Picatout/PICvision/docs/assy-completed-with-mcu-installed.JPG

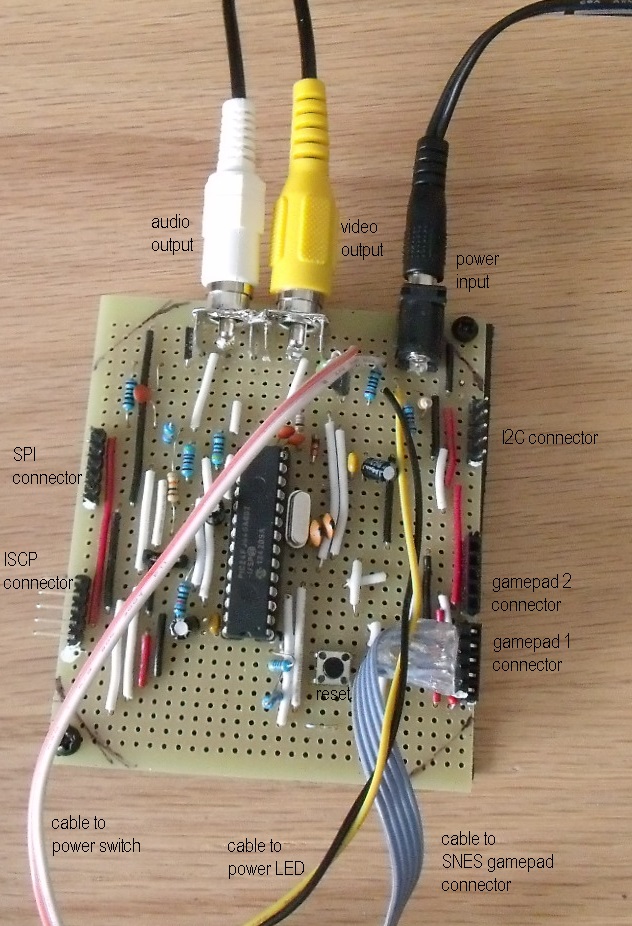
docs/assy-completed-with-mcu-installed.JPG
