Picatout/PICvision/docs/vector-8022.jpg

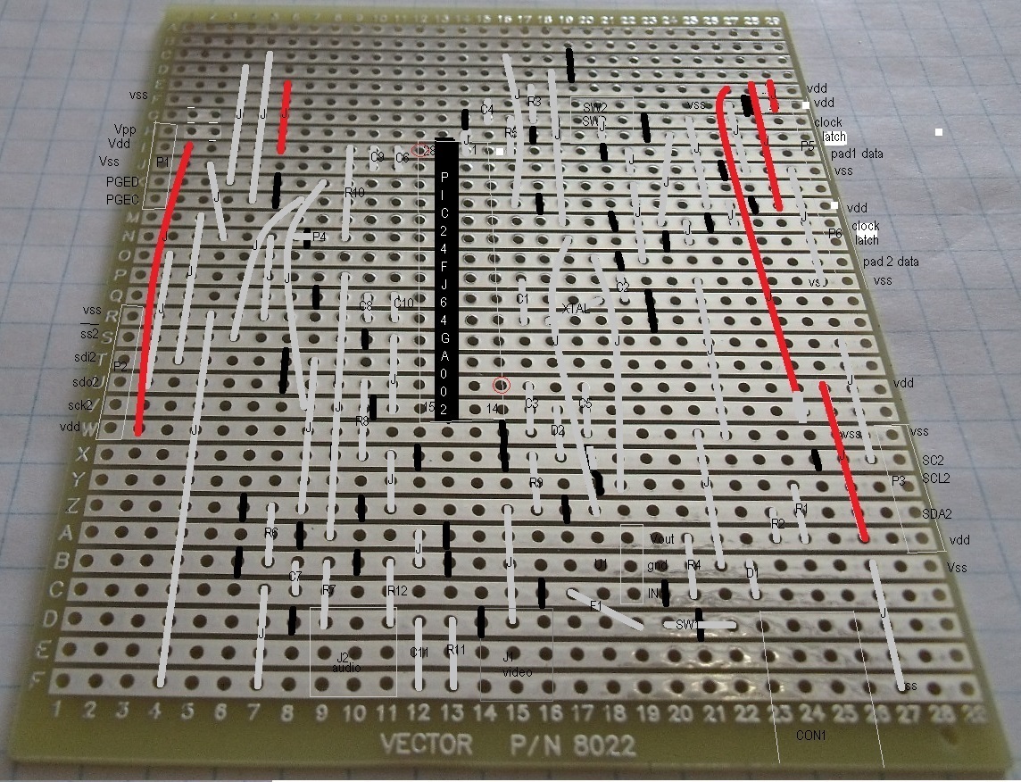
docs/vector-8022.jpg
