Picatout/PICvision/README.md

PICvision
=========

a simple game console inspired by HACKvision but using a PIC24FJ64GA002 instead of atMega328P-PU

specifications:
---------------
video mode: monochrome NTSC/PAL composite outpute
resolution: 216x216
controls: 2 SNES gamepad input
audio: white noise, square wave tones, PWM DAC
extra interfaces: 1 x I2C,  1 x SPI

Source code licenced under GNU GPLv3
Others documents licenced under Creative Commons  CC-BY-SA
