Picatout/PICvision/docs/assy-completed-down-side.JPG

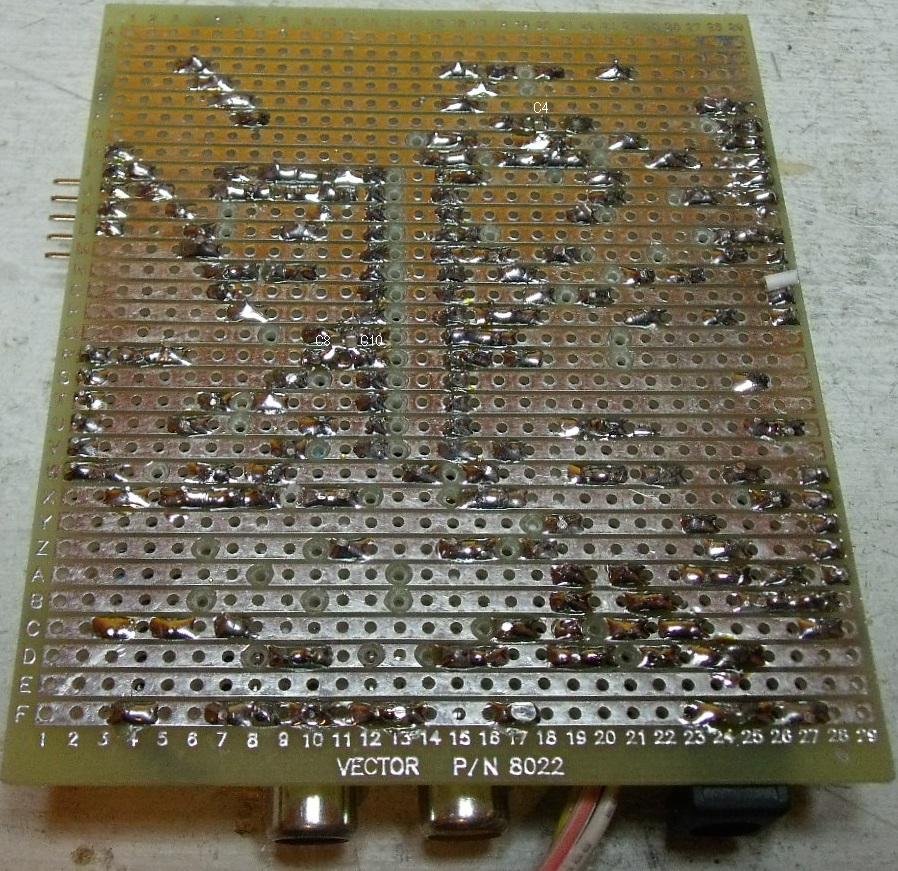
docs/assy-completed-down-side.JPG
