Picatout/PICvision/docs/assy-completed-led-switch.JPG

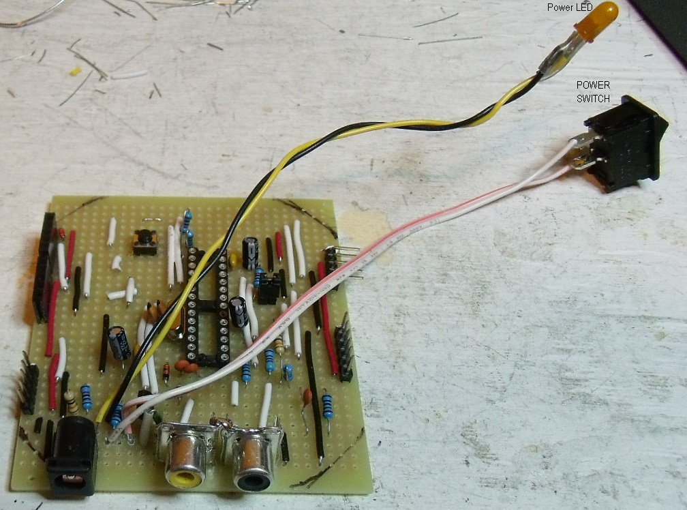
docs/assy-completed-led-switch.JPG
