Picatout/PICvision/docs/assy-completed-top-side.JPG

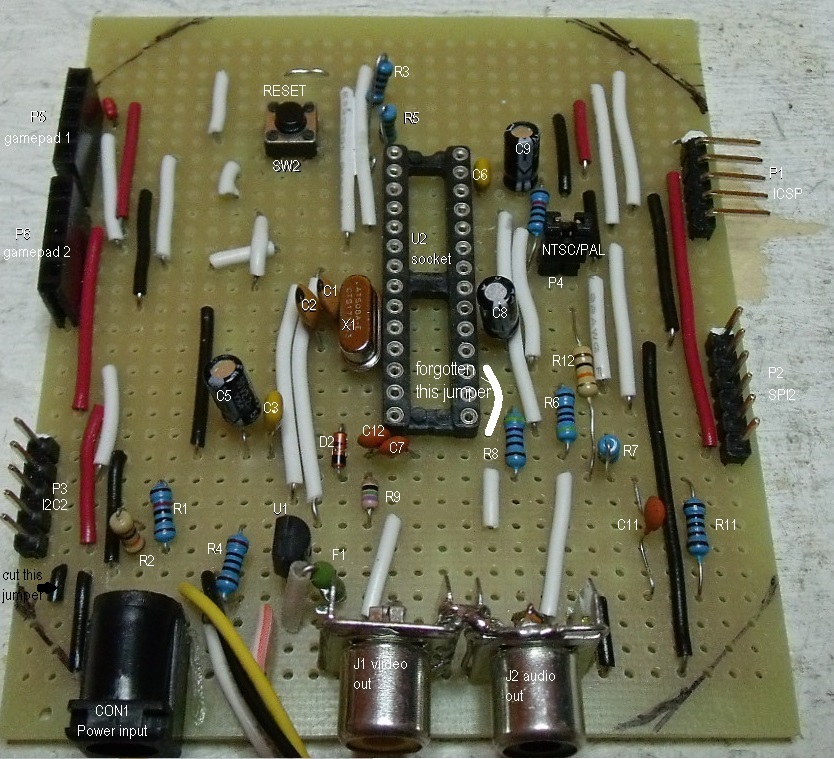
docs/assy-completed-top-side.JPG
