Picatout/PICvision/docs/assy-wires-and-connectors.JPG

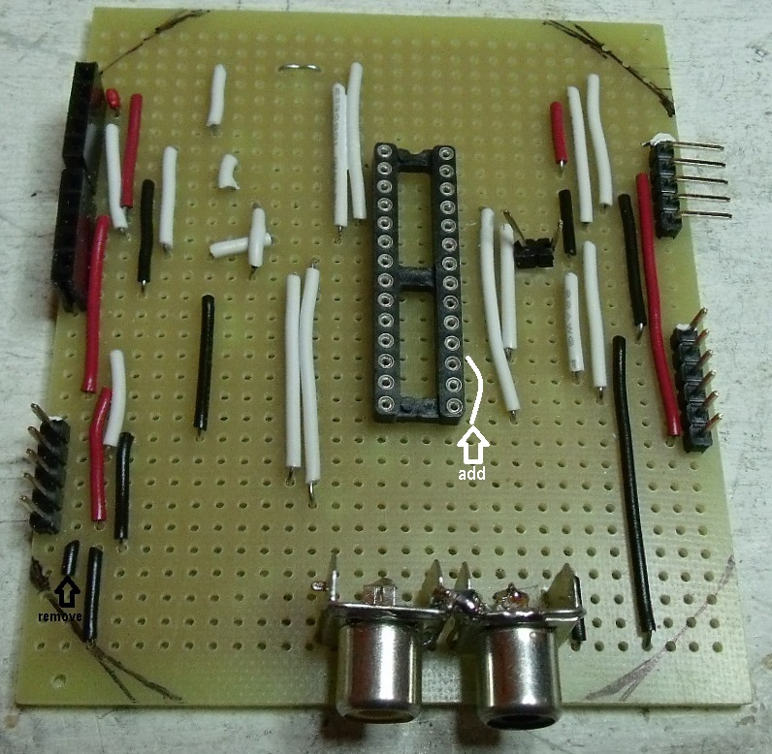
docs/assy-wires-and-connectors.JPG
