Picatout/PICvision/docs/PICvison-game-console.JPG

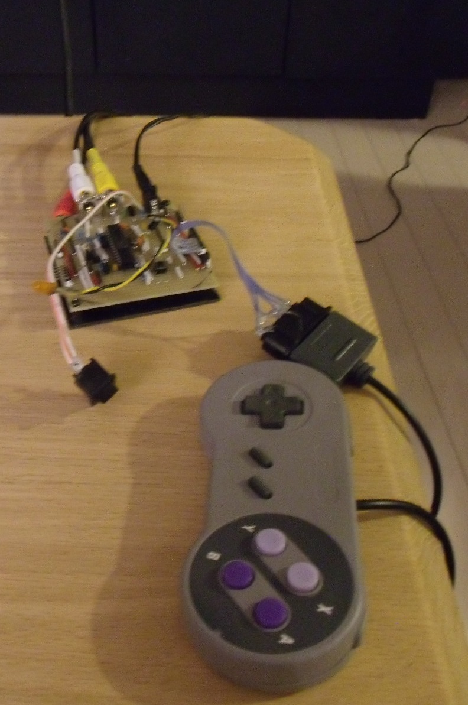
docs/PICvison-game-console.JPG
