Picatout/PICvision/docs/protoboard-strip-cutted.JPG

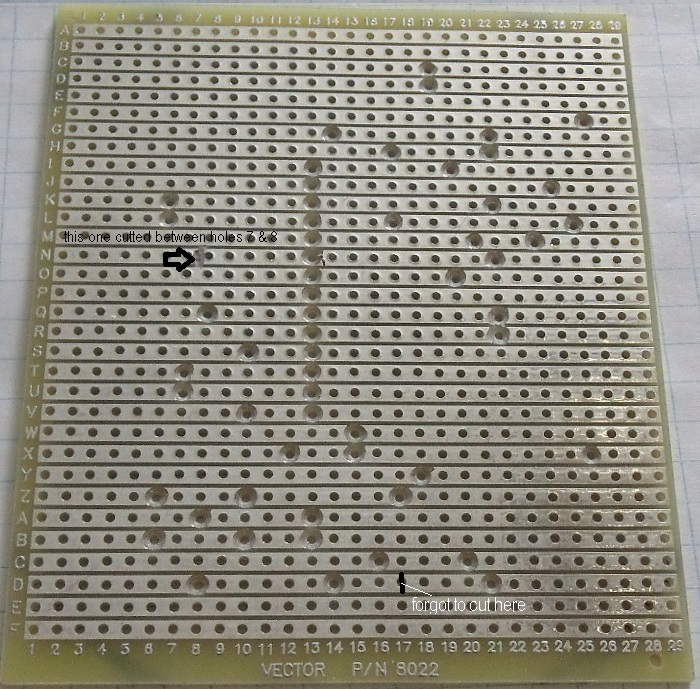
docs/protoboard-strip-cutted.JPG
