Picatout/PICvision/docs/schématique.png

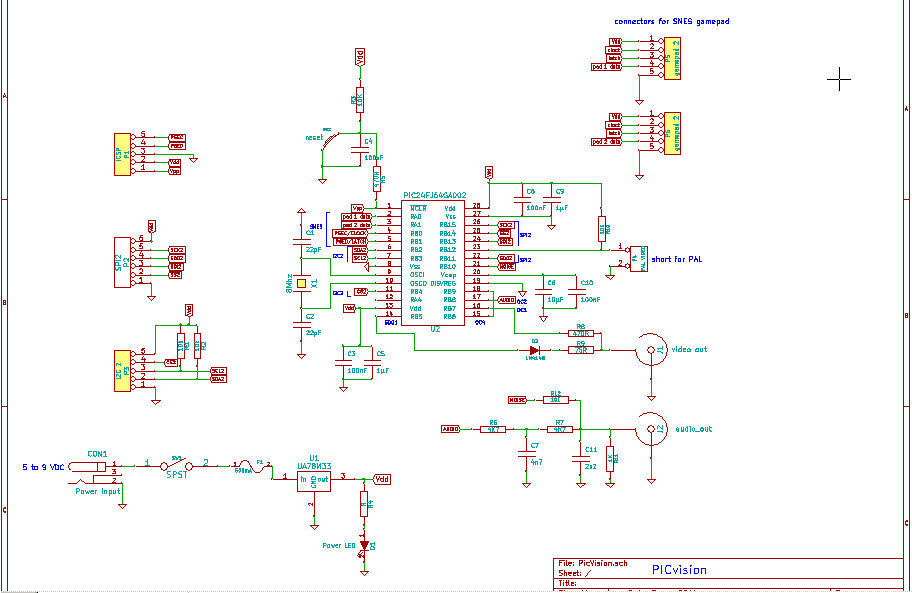
docs/schématique.png
