Picatout/PICvision/docs/electronic schematic.pdf

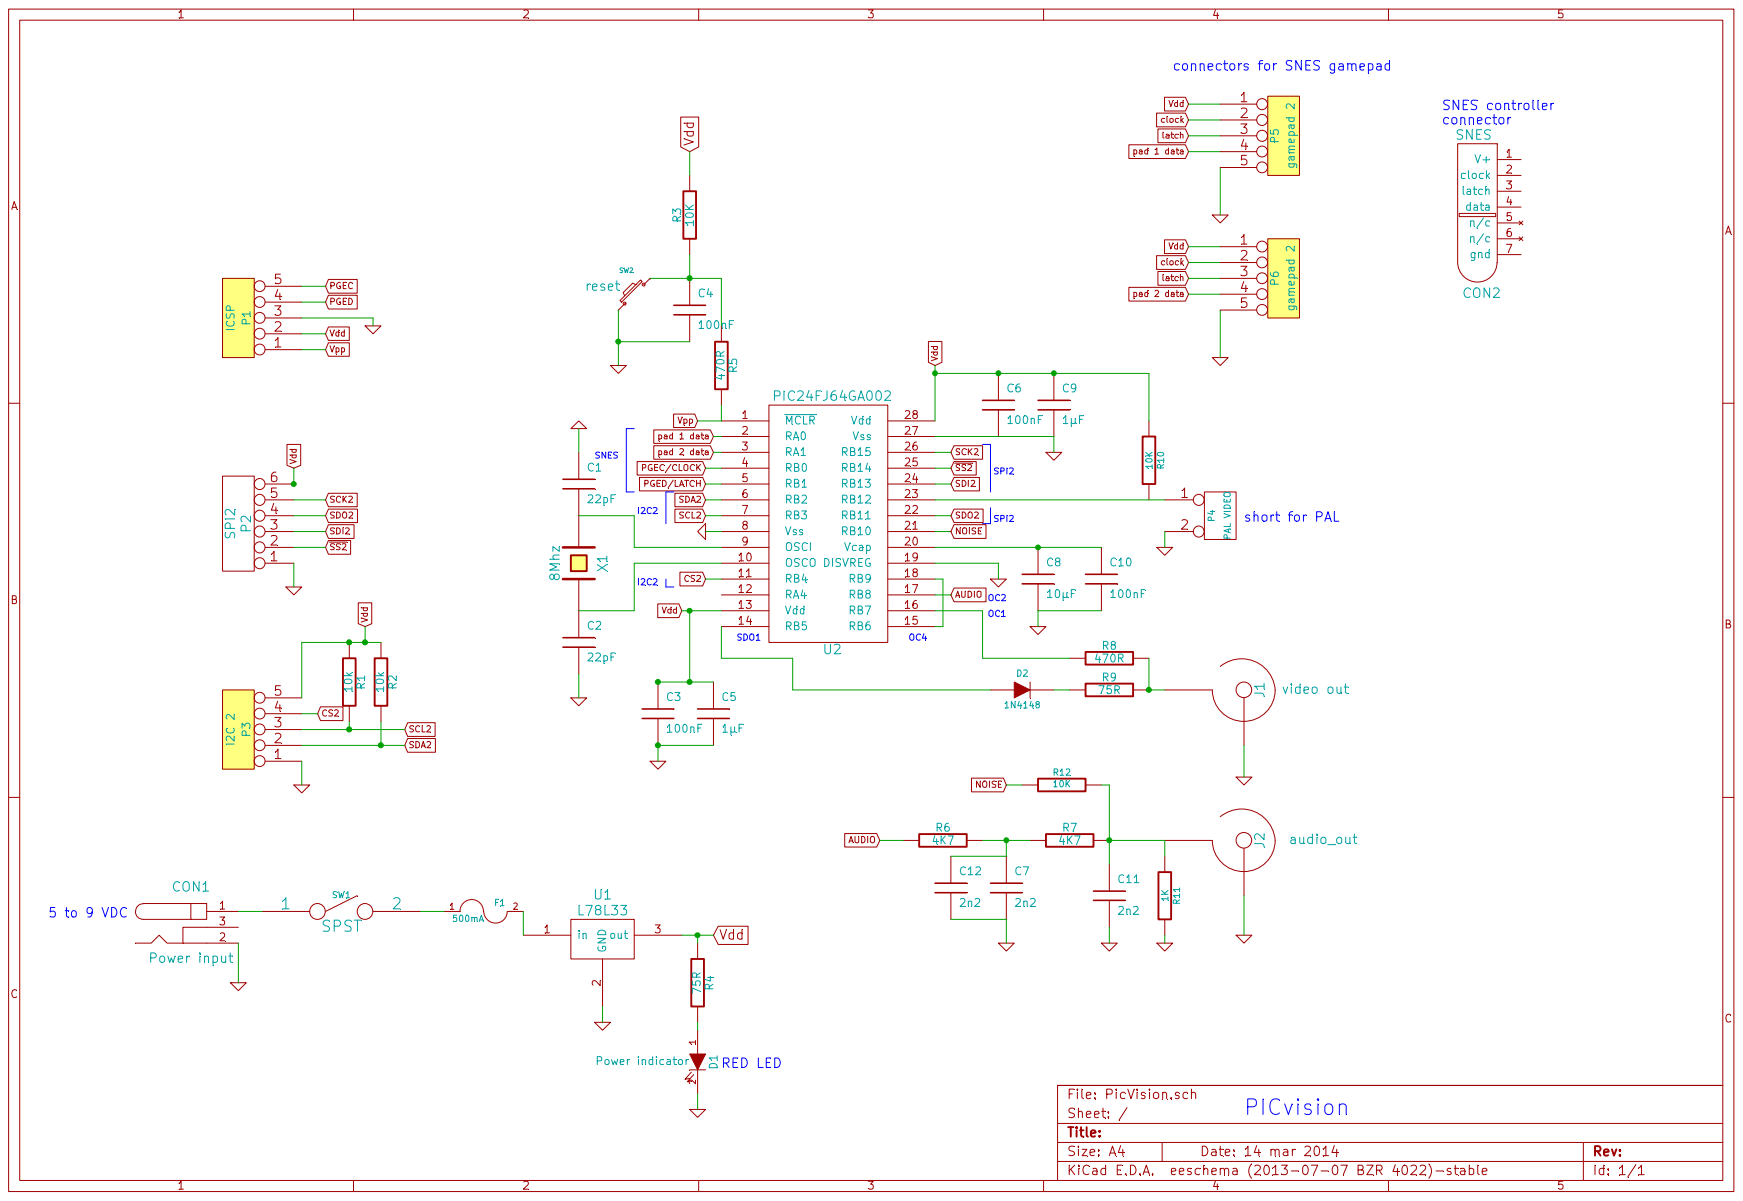
[picture p17: page 1]
