Picatout/PICvision/KiCad/PicVision.sch

## KiCad design KiCad/PicVision.sch (2014-03-14)

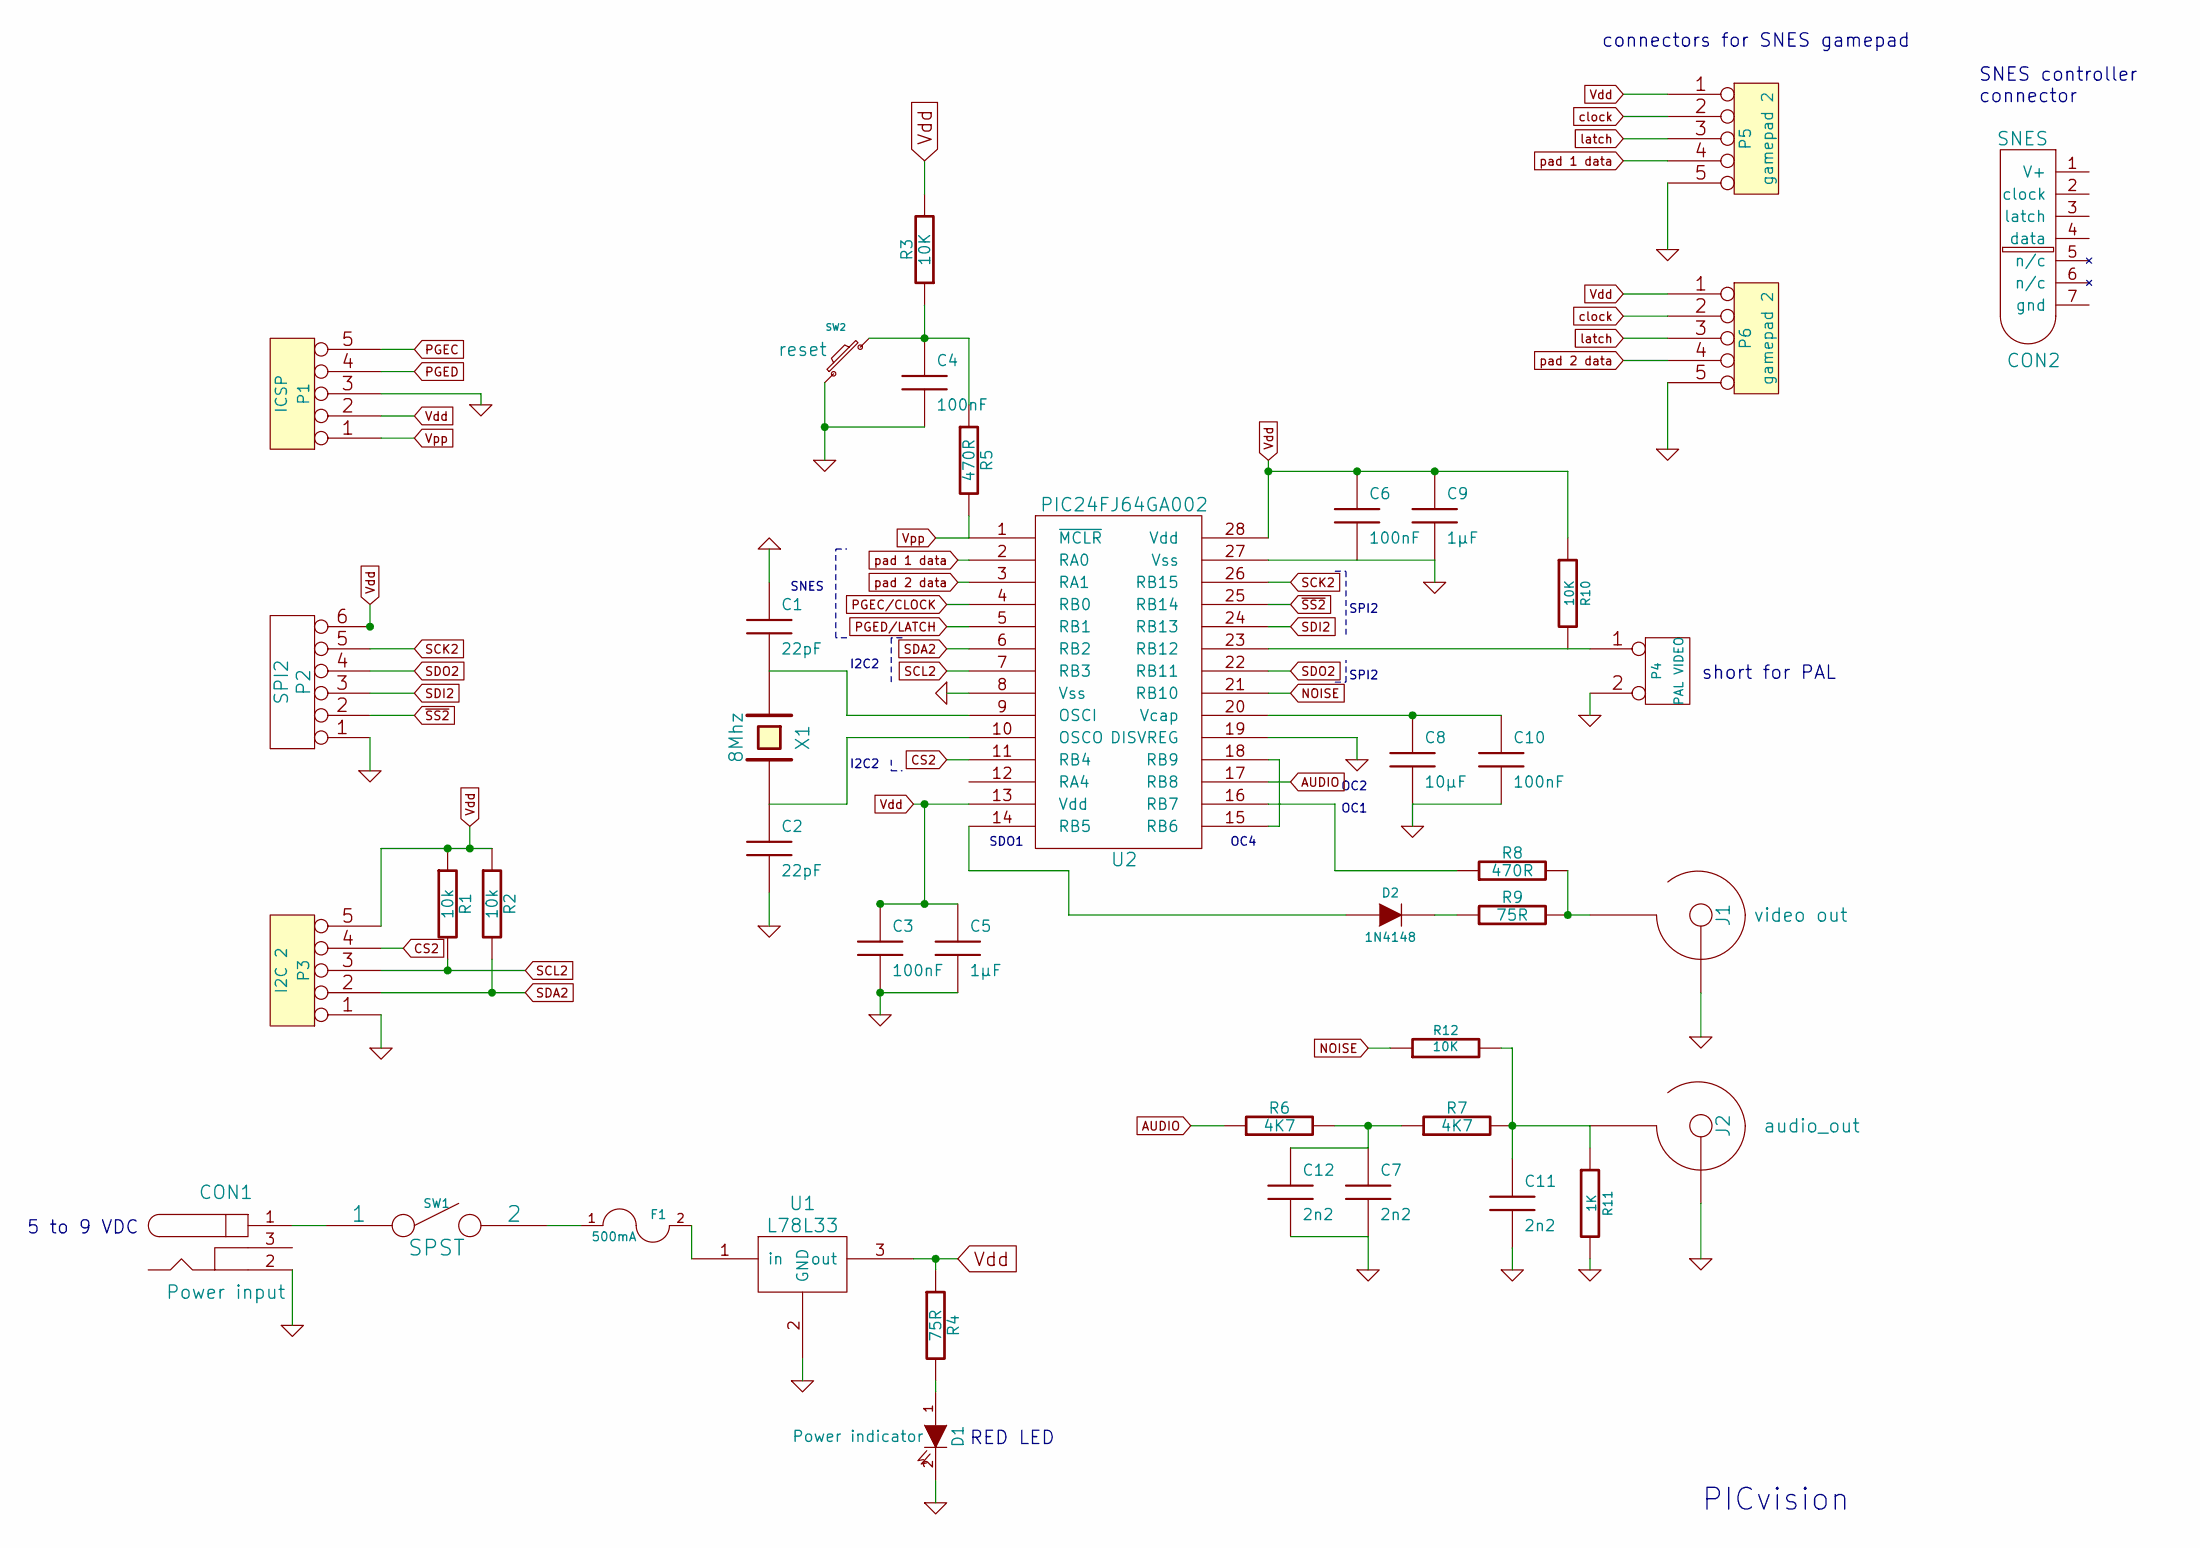
[picture p18: schematic PicVision.sch]

Parts:
C1, C2: 22pF
C3, C4, C6, C10: 100nF
C5, C9: 1µF
C7, C11, C12: 2n2
C8: 10µF
CON1: Power input
CON2: SNES
D1: Power indicator
D2: 1N4148
F1: 500mA
J1: video out
J2: audio_out
P1: ICSP
P2: SPI2
P3: I2C 2
P4: PAL VIDEO
P5, P6: gamepad 2
R1, R2: 10k
R3: 10K
R4, R9: 75R
R5, R8: 470R
R6, R7: 4K7
R10, R12: 10K
R11: 1K
SW1: SPST
SW2: reset
U1: L78L33
U2: PIC24FJ64GA002
X1: 8Mhz

Connections:
AUDIO: R6.1, U2.17 (RB8)
CS2: P3.4, U2.11 (RB4)
GND: C1.1, C2.2, C3.2, C4.2, C5.2, C7.2, C8.2, C9.2, C10.2, C11.2, C12.2, CON1.2, D1.2 (K), J1.~, J2.~, P1.3, P2.1, P3.1, P4.2 (PM), P5.5, P6.5, R11.2, SW2.1, U1.2 (GND), U2.8 (Vss), U2.19 (DISVREG), U2.27 (Vss)
NOISE: R12.1, U2.21 (RB10)
unnamed: C1.2, U2.9 (OSCI), X1.1
unnamed: C2.1, U2.10 (OSCO), X1.2
unnamed: C4.1, R3.1, R5.1, SW2.2
unnamed: C8.1, C10.1, U2.20 (Vcap)
unnamed: C11.1, J2.~, R7.2, R11.1, R12.2
unnamed: C7.1, C12.1, R6.2, R7.1
unnamed: CON1.1, SW1.1
unnamed: D1.1 (A), R4.2
unnamed: D2.1 (A), U2.14 (RB5)
unnamed: D2.2 (K), R9.1
unnamed: F1.1, SW1.2
unnamed: F1.2, U1.1 (in)
unnamed: J1.~, R8.2, R9.2
unnamed: P4.1, U2.23 (RB12)
unnamed: R8.1, U2.16 (RB7)
unnamed: U2.15 (RB6), U2.18 (RB9)
PGEC: P1.5
PGEC/CLOCK: U2.4 (RB0)
PGED: P1.4
PGED/LATCH: U2.5 (RB1)
SCK2: P2.5, U2.26 (RB15)
SCL2: P3.3, R1.2, U2.7 (RB3)
SDA2: P3.2, R2.2, U2.6 (RB2)
SDI2: P2.3, U2.24 (RB13)
SDO2: P2.4, U2.22 (RB11)
Vdd: C3.1, C5.1, C6.1, C9.1, P1.2, P2.6, P3.5, P5.1, P6.1, R1.1, R2.1, R3.2, R4.1, R10.1, U1.3 (out), U2.13 (Vdd), U2.28 (Vdd)
Vpp: P1.1, R5.2, U2.1 (~MCLR)
clock: P5.2, P6.2
latch: P5.3, P6.3
pad 1 data: P5.4, U2.2 (RA0)
pad 2 data: P6.4, U2.3 (RA1)
~SS2: P2.2, U2.25 (RB14)

Notes on the sheet:
connectors for SNES gamepad
5 to 9 VDC
PICvision
short for PAL
SPI2
SNES
SDO1
OC1
OC4
OC2
I2C2
SNES controller connector
RED LED
