Picatout/PICvision/(commit log)

2014-02-27 Began software work.
    [PicVision.sch]
2014-02-28 work on TVout
    [PicVision.sch]
2014-03-01 modification du schematic to account for switch PIC24FJ64GA002 by PIC32MX150F128B.
    [PicVision.sch]
2014-03-01 schematic update
    [PicVision.sch]
2014-03-03 work on sound.c
    [PicVision.sch]
2014-03-04 work on paddle interface
    [PicVision.sch]
2014-03-08 stripboard wiring
    [PicVision.sch]
2014-03-09 prototype board
    [$PicVision.sch]
2014-03-10 mod. to electronic schematic
    [$PicVision.sch, PicVision.sch]
2014-03-10 mod. to electronic schemtatic
    [PicVision.sch]
2014-03-10 added electronic schematic in pdf format
2014-03-10 correction to vector board assembly drawing
2014-03-12 added assembly photos
    [PicVision.sch]
2014-03-14 schematic update + bom
    [PicVision.sch]
